Eurobot-2026/jon-snowbot/electronics/BOM.xlsx

Name of the component | Pcs | Details | Purpose | Vendor | Ref. | Price HT | Price HT/pc | Link | Notes/Remarks | Statuts
Motors | 4 | 12V 76RPM Ø37x95 mm (16mm shaft included) 210g | Movement | GoTronic | 4756 | 246.68 € | 61.67 € | https://www.gotronic.fr/art-motoreducteur-encodeur-4756-28114.htm |  | TRUE
Motor Brackets | 4 | Twelve 5mm M3 screws | Support | GoTronic | 1084 | 40.68 € | 10.17 € | Paire de supports moteurs 1084 - Gotronic (https://www.gotronic.fr/art-paire-de-supports-moteurs-1084-33031.htm) |  | TRUE
Motor Drivers | 2 | 5,5*5*4 cm 5.5V~27V 43A 70g | Motor Control | High-Tech Place | SH987L831 | 63.80 € | 15.95 € | https://www.hightechplace.com/ldtr-wg0247-h-bridge-pwm-semiconductor-double-bts7960b-dc-43a-pilote-de-moteur-pas-a-pas-bleu.html |  | TRUE
Battery Charger | 1 | 1000mA 105g 390min 10W 4.75V | Charging Battery | RS Pro | 146-6770 | 19.96 € | 19.96 € | 1001-0050 | Chargeur de batterie, 1.45V, 3.7 V, 4.2 V Lithium-ion, NiMH 1000 mA Ansmann 18650, AAA, 22650, AA, 16340, 17670, 18500, | RS (https://fr.rs-online.com/web/p/chargeurs-de-batterie/1466770) |  | TRUE
Camera | 1 | 3280 x 2464 pixel | Detection | RS Pro | 247-3234 | 43.18 € | 43.18 € | FIT0729 | Caméra Raspberry Pi DFRobot, USB 2.0 3280 x 2464 pixel | RS (https://fr.rs-online.com/web/p/cameras-pour-raspberry-pi/2473234) |  | TRUE
Arduino Mega | 1 | 5V 16MHz 8KB SRAM | Processing | RS Pro | 715-4084 | 48.24 € | 48.24 € | A000067 | Arduino MEGA 2560 Rév. 3 | RS (https://fr.rs-online.com/web/p/arduino/7154084?gb=a) |  | TRUE
Voltage Regulator | 1 | 27.3*20mm 12V/3.3V-5V | Conversion | GoTronic | DFR1015 | 5.33 € | 5.33 € | https://www.gotronic.fr/art-regulateur-3-3-5-9-ou-12-vcc-dfr1015-35757.htm |  | TRUE
Mecanum wheels | 4 | Ø65 x 43 mm | Omnidirectional | GoTronic | FIT0779/FIT0780 | 9.92 € | 9.92 € | Roue omnidirectionnelle droite FIT0780 - Gotronic (https://www.gotronic.fr/art-roue-omnidirectionnelle-droite-fit0780-34179.htm) |  | TRUE
Jumper M/M | 5 | 10pcs 150mm 24AWG | Wiring | RS Pro | 791-6463 | 3.58 € | 3.58 € | Strap pour platine d'essai, MikroElektronika, MIKROE-513, 150mm, couleur Noir, Bleu, Marron, Vert, Gris, Orange, | RS (https://fr.rs-online.com/web/p/straps-pour-platines-d-essai/7916463) |  | TRUE
Jumper M/F | 5 | 40pcs 200mm 24AWG | Wiring | RS Pro | 204-8243 | 3.24 € | 3.24 € | Strap pour platine d'essai, Kitronik, 4128-40, 200mm, couleur Noir, Bleu, Marron, Vert, Gris, Orange, Violet, Rouge, | RS (https://fr.rs-online.com/web/p/straps-pour-platines-d-essai/2048243) |  | TRUE
Jumper F/F | 5 | 10pcs 150mm 24AWG | Wiring | RS Pro | 791-6450 | 3.58 € | 3.58 € | Strap pour platine d'essai, MikroElektronika, MIKROE-511, 150mm, couleur Noir, Bleu, Marron, Vert, Gris, Orange, | RS (https://fr.rs-online.com/web/p/straps-pour-platines-d-essai/7916450?gb=a) |  | TRUE
Ultrasonic Sensor | 2 | DC 5V 15mA 40Hz 45*20*15mm | Detection | RS Pro | 215-3181 | 6.34 € | 3.17 € | 46130 | Kitronik Capteur de distance ultrasonique version HC-SR04 5 V. Capteur | RS (https://fr.rs-online.com/web/p/complements-bbc-micro-bit/2153181?gb=a) |  | TRUE
LiPo Battery | 3 | 42g 18650 2Ah 3.7V | Power Supply | RS Pro | 196-922 | 33.15 € | 11.05 € | Batterie rechargeable RS PRO, 18650 IEC 62133 3.7 V Lithium-ion 2000 mAh 18.5 mm | RS (https://fr.rs-online.com/web/p/piles-rechargeables-taille-speciale/0196922) |  | FALSE
RDK X5 | 1 | 8-Core CPU 4GB Ubuntu 22.04 | Processing | DFrobot | DFR1238 | 85.25 € | 85.25 € | D-Robotics RDK X5 AI Robot Development Board | ROS Robot Kit - DFRobot (https://www.dfrobot.com/product-2945.html) |  | FALSE
Emergency Button | 1 | Ø16mm 250V | Safety | RS Pro | 745-2442 | 25.06 € | 25.06 € | https://befr.rs-online.com/web/p/emergency-stop-push-buttons/7452442?gb=a | Datasheet (https://docs.rs-online.com/cc2d/A700000007881577.pdf) | FALSE
Servomotor | 1 | 5V to 8.4V 55mm 66 RPM | Positionning | Mouser | SER0063 | 13.67 € | 13.67 € | https://www.mouser.fr/ProductDetail/DFRobot/SER0063 |  | FALSE
