Eurobot-2026/jon-snowbot/mam_eurobot_2026/models/cursor/meshes/cursor.stl

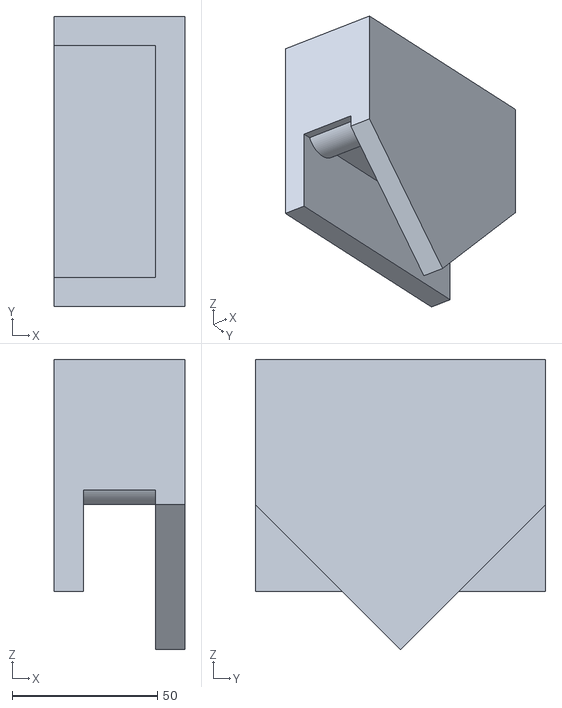
[picture p6: CAD file, 2026-01-21]
mam_eurobot_2026/models/cursor/meshes/cursor.stl
45.0 x 100.0 x 100.0
