Eurobot-2026/jon-snowbot/electronics/EUROBOT.kicad_sch

## KiCad design electronics/EUROBOT.kicad_sch (2026-06-02)

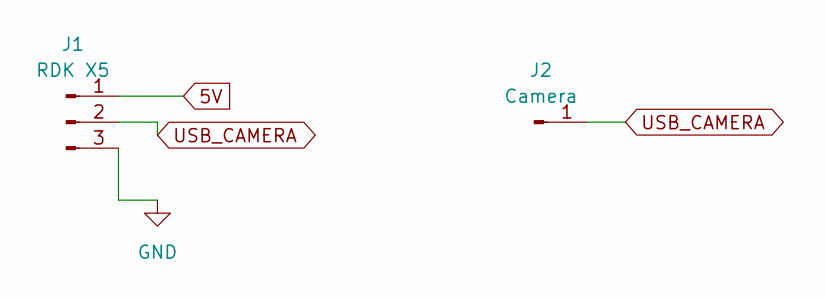
[picture p7: schematic EUROBOT.kicad_sch]

Parts:
J1: RDK X5
J2: Camera

Connections:
5V: J1.1
GND: J1.3
USB_CAMERA: J1.2, J2.1
