Eurobot-2026/jon-snowbot/electronics/robocup.kicad_sch

## KiCad design electronics/robocup.kicad_sch (2026-06-02)

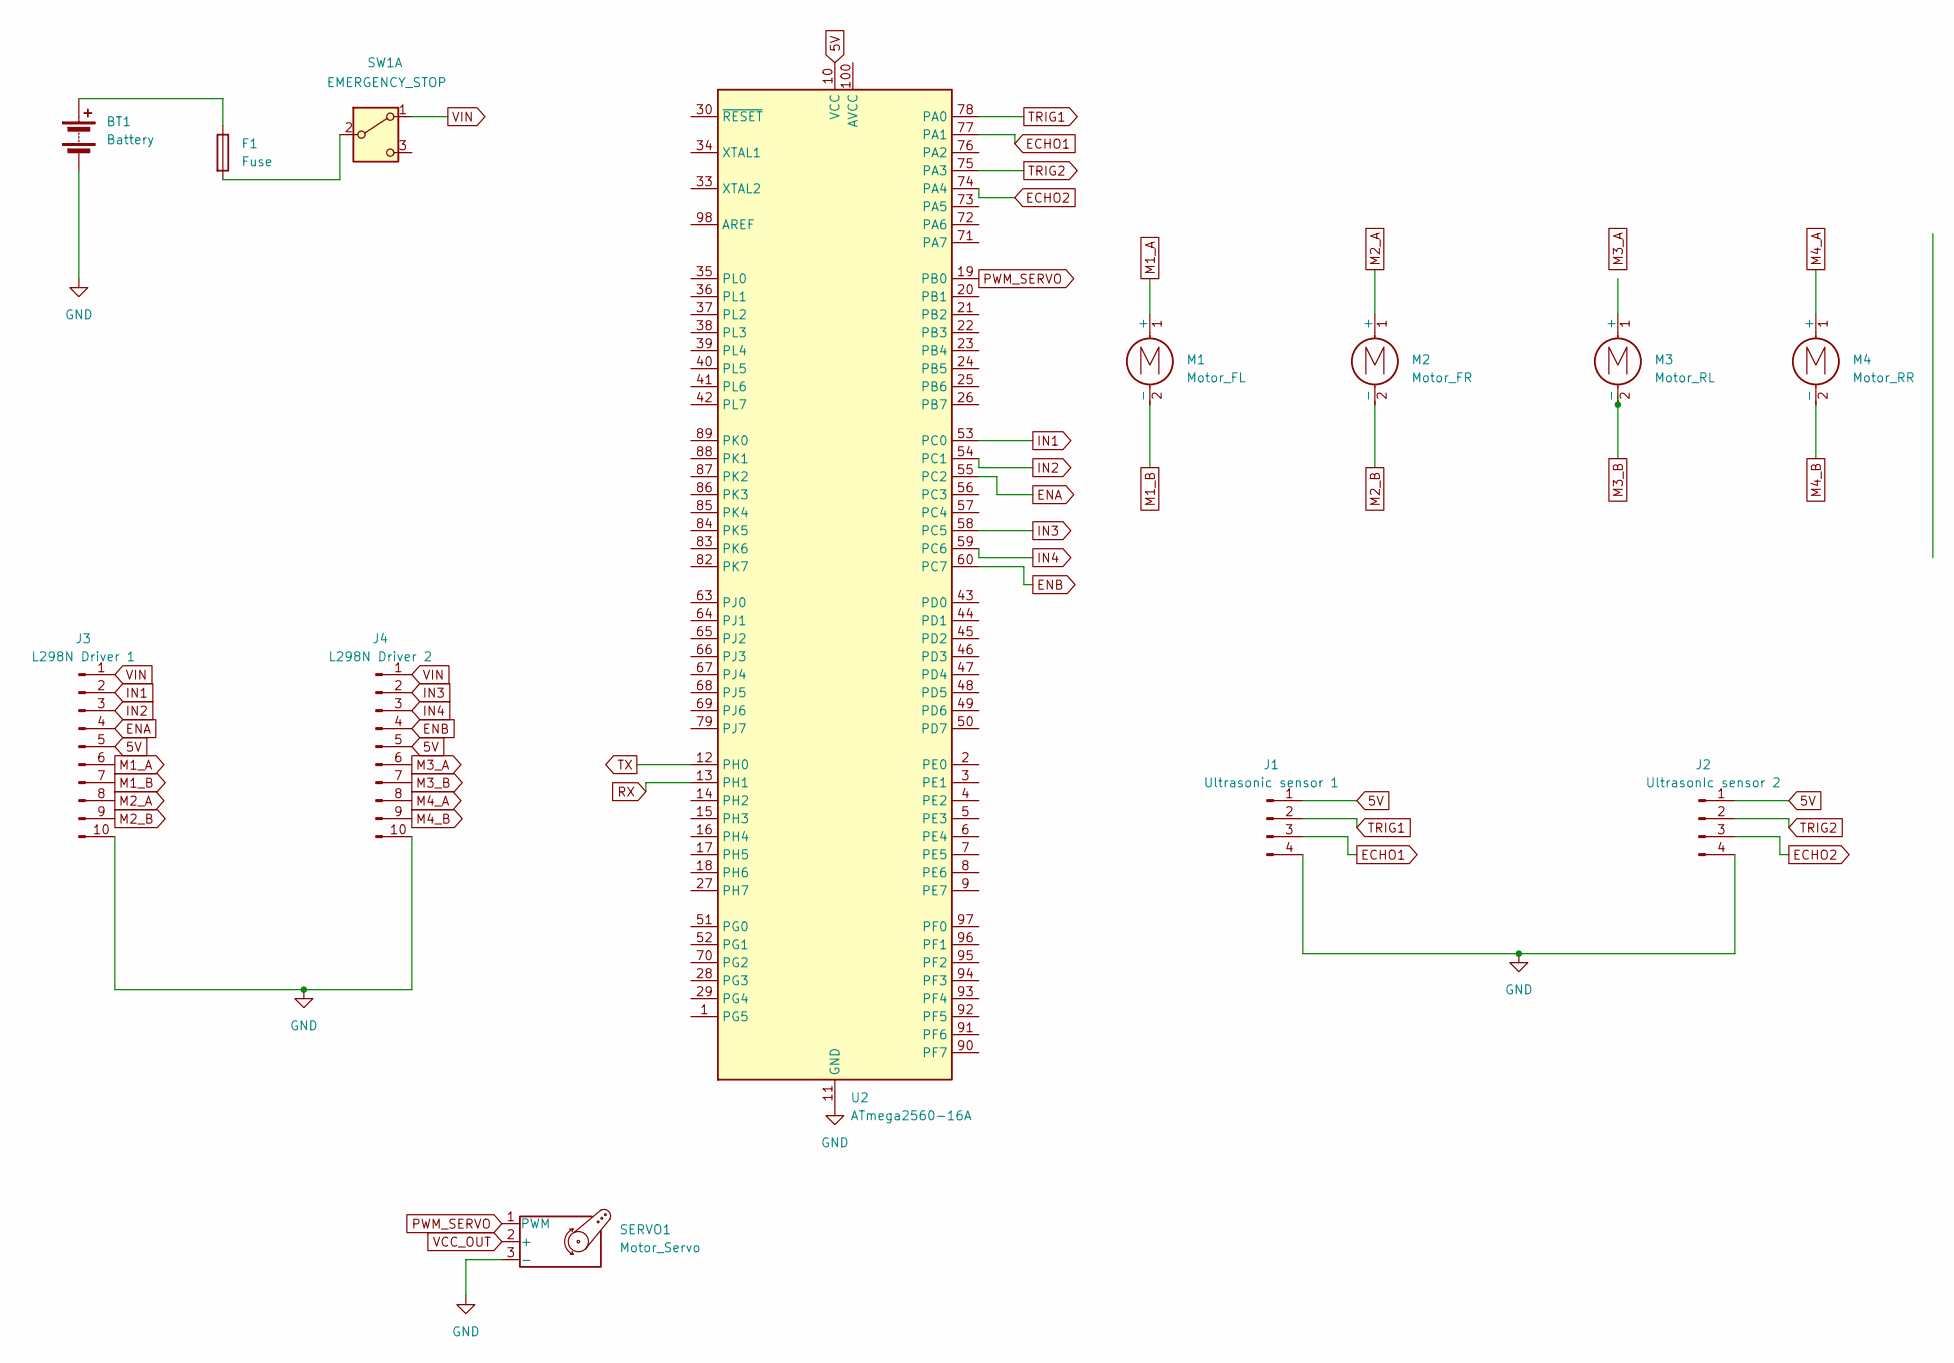
[picture p8: schematic robocup.kicad_sch]

Parts:
BT1: Battery
F1: Fuse
J1: Ultrasonic sensor 1
J2: UltrasonIc sensor 2
J3: L298N Driver 1
J4: L298N Driver 2
M1: Motor_FL
M2: Motor_FR
M3: Motor_RL
M4: Motor_RR
SERVO1: Motor_Servo
SW1: EMERGENCY_STOP
U2: ATmega2560-16A; TQFP-100_14x14mm_P0.5mm

Connections:
5V: J1.1, J2.1, J3.5, J4.5, U2.10 (VCC), U2.31 (VCC), U2.61 (VCC), U2.80 (VCC)
ECHO1: J1.3, U2.77 (PA1)
ECHO2: J2.3, U2.74 (PA4)
ENA: J3.4, U2.55 (PC2)
ENB: J4.4, U2.60 (PC7)
GND: BT1.2 (-), J1.4, J2.4, J3.10, J4.10, SERVO1.3 (-), U2.11 (GND), U2.32 (GND), U2.62 (GND), U2.81 (GND), U2.99 (GND)
IN1: J3.2, U2.53 (PC0)
IN2: J3.3, U2.54 (PC1)
IN3: J4.2, U2.58 (PC5)
IN4: J4.3, U2.59 (PC6)
M1_A: J3.6, M1.1 (+)
M1_B: J3.7, M1.2 (-)
M2_A: J3.8, M2.1 (+)
M2_B: J3.9, M2.2 (-)
M3_A: J4.6
M3_B: J4.7, M3.2 (-)
M4_A: J4.8, M4.1 (+)
M4_B: J4.9, M4.2 (-)
unnamed: BT1.1 (+), F1.1
unnamed: F1.2, SW1.2 (B)
PWM_SERVO: SERVO1.1 (PWM), U2.19 (PB0)
RX: U2.13 (PH1)
TRIG1: J1.2, U2.78 (PA0)
TRIG2: J2.2, U2.75 (PA3)
TX: U2.12 (PH0)
VCC_OUT: SERVO1.2 (+)
VIN: J3.1, J4.1, SW1.1 (A)
