Eurobot-2026/jon-snowbot/(commit log)

2025-11-17 change camera from beacons to observation device
    [competition_world.sdf]
2025-11-20 Estimation of cursor position
    [model.sdf]
2025-11-22 the robot moves with a test movement file. strafing doesn't work yet
    [model.sdf]
2025-11-24 changes in aruco detection
    [model.sdf]
2025-12-06 - changed wheel_controller.py location to new folder movement - added mecanum wheels wheels still don't work, robot explodes upon sim run. to be continued...
    [model.sdf]
2025-12-06 added meshes for the mecanum wheels and new movement folder
    [base_link.stl, roller_10_1.stl, roller_11_1.stl, roller_12_1.stl, roller_13_1.stl, roller_14_1.stl, roller_15_1.stl, roller_16_1.stl]
2025-12-27 visualize cursor frame
2026-01-04 path planner
    [robot_model.yaml]
2026-01-05 bug fixed
    [competition_world.sdf]
2026-01-09 add gripper on simple robot
    [model.sdf]
2026-01-09 implement gripper teleop
2026-01-09 fix gripper issue
    left finger was not activated, but now it is available by adding another controller on left
    [model.sdf]
2026-01-09 fix gripper position
    [model.sdf]
2026-01-11 urdf for baselink -> camera TF
    not tested
    [simple_robot_camera.urdf]
2026-01-11 new TF
    transformation from crate pos with respect to camera frame into crate pos with respect to map, but not tested
2026-01-19 dammy localization launch
    but has bugs that no data is in /model/simple_robot/odometry, though the bridge was built.
2026-01-21 change to initial robot
    [model.sdf]
2026-01-21 add gripper
    [model.sdf]
2026-01-21 discard mechanim parts
    [base_link.stl, roller_10_1.stl, roller_11_1.stl, roller_12_1.stl, roller_13_1.stl, roller_14_1.stl, roller_15_1.stl, roller_16_1.stl]
2026-01-21 made base link visual small
    [model.sdf]
2026-01-21 change in method
    for dummy localization method has changed;
    before; extract robot pose from gazebo topic
    but it was found difficult to realize
    after; set pose publisher on robot
    [model.sdf]
2026-01-22 solve some issues
    [model.sdf]
2026-01-22 made fixed path following
    [robot_model.yaml]
2026-01-23 add issues on camera
2026-06-02 I added the documentation of the electronics part, the BOM and the circuits diagrams
    [BOM.xlsx, EUROBOT.kicad_sch, robocup.kicad_sch]
2026-06-02 All the work done related to ultrasonic sensor & PID
2026-06-03 added code to test wifi card on arduino. it didn't work during testing
2026-06-03 code to send flag to arduino
